stefanVanadium/mp3-player/mp3_player.tex

\documentclass[11pt,a4paper]{article}
\usepackage[utf8]{inputenc}
\usepackage[T1]{fontenc}
\usepackage[english]{babel}
\usepackage[margin=2.5cm]{geometry}
\usepackage{graphicx}
\usepackage{hyperref}

\title{MP3 Player}
\author{Stefan Jipa}
\date{\today}

\begin{document}
\maketitle
\tableofcontents
\newpage

\section{Goal}

\section{Requirements}

\section{Components}

\section{Schematic}

\section{Software}

\section{Tests}

\section{Resources}

\end{document}
