stefanVanadium/mp3-player/enclosure/out/compare.png

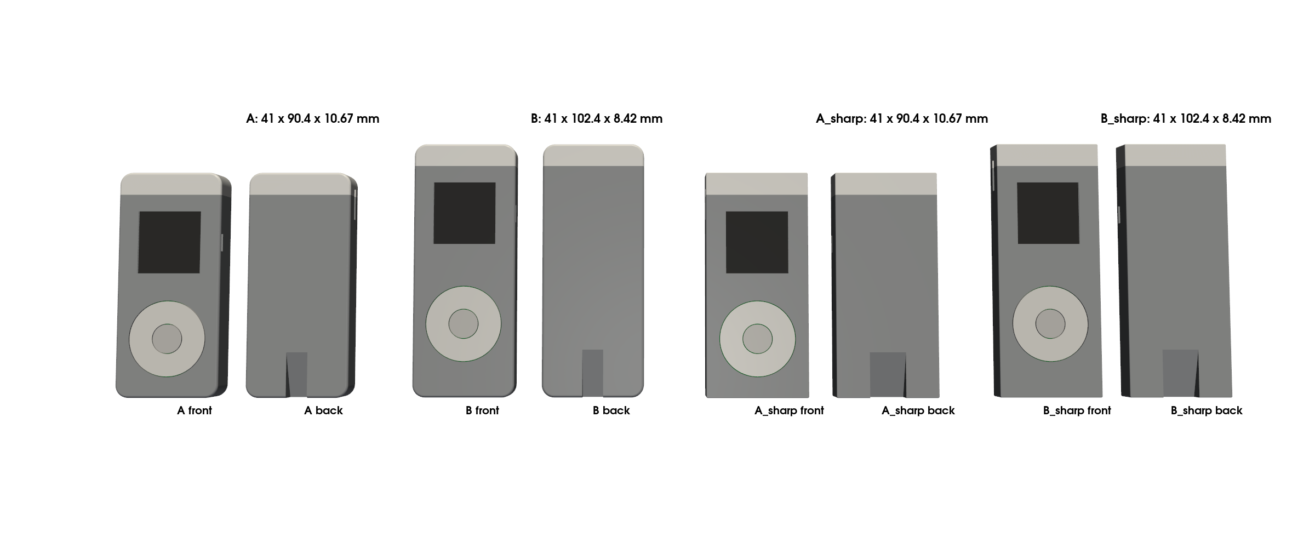
enclosure/out/compare.png
