stefanVanadium/mp3-player/enclosure/out/ends_ortho.png

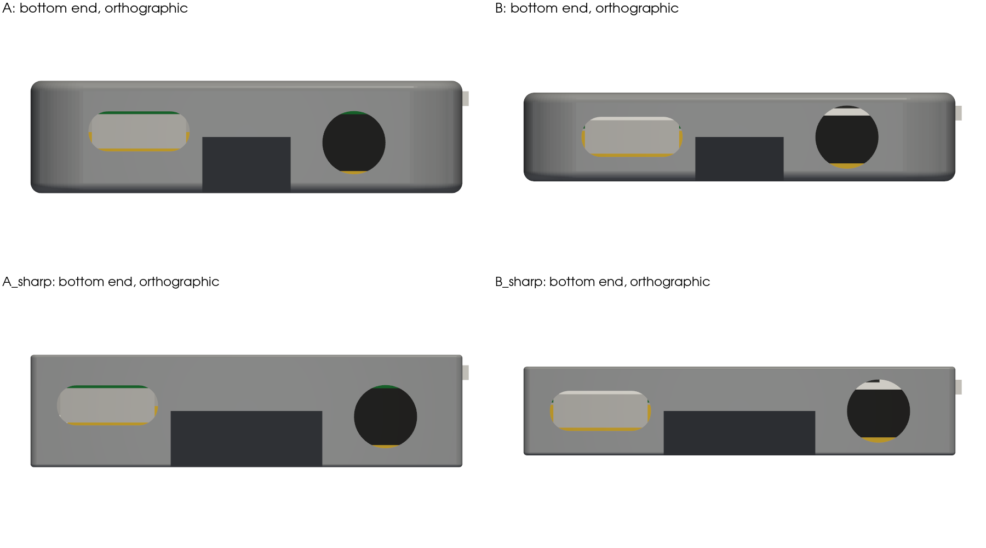
enclosure/out/ends_ortho.png
