stefanVanadium/mp3-player/enclosure/out/render_A.png

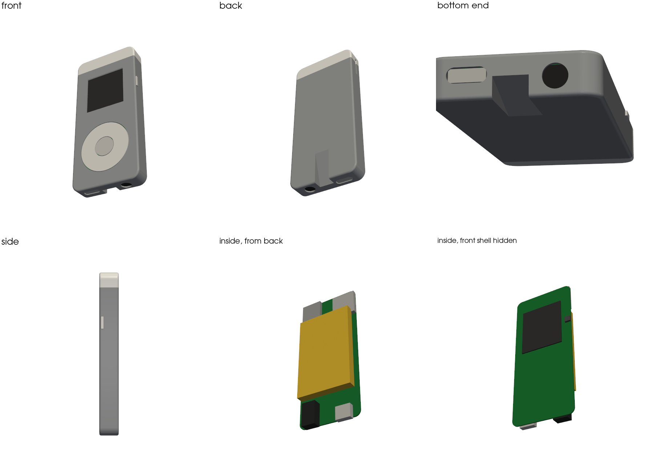
enclosure/out/render_A.png
