stefanVanadium/mp3-player/enclosure/out/render_B_sharp.png

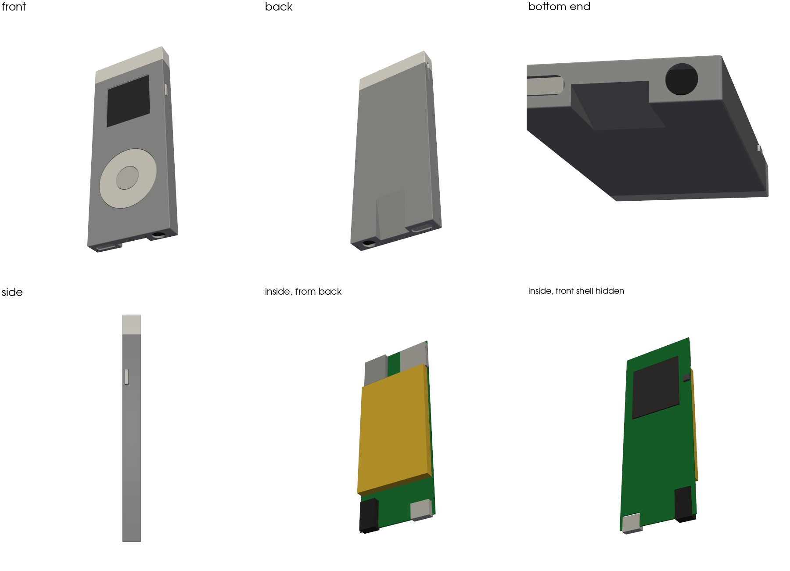
enclosure/out/render_B_sharp.png
