stefanVanadium/mp3-player/enclosure/out/concept_B_body.stl

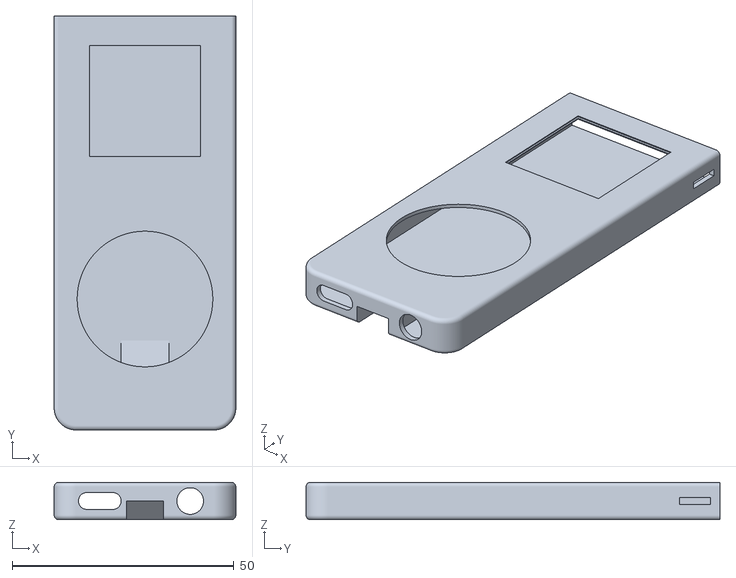
[picture p6: CAD file, 2026-10-23]
enclosure/out/concept_B_body.stl
41.0 x 93.4 x 8.42
