stefanVanadium/mp3-player/examplev1.dxf

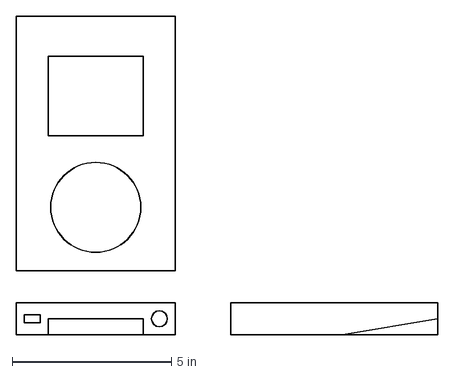
[picture p7: CAD file, 2026-10-22]
examplev1.dxf
13.2 x 10.0 in
