stefanVanadium/mp3-player/enclosure/out/concept_A_body.stl

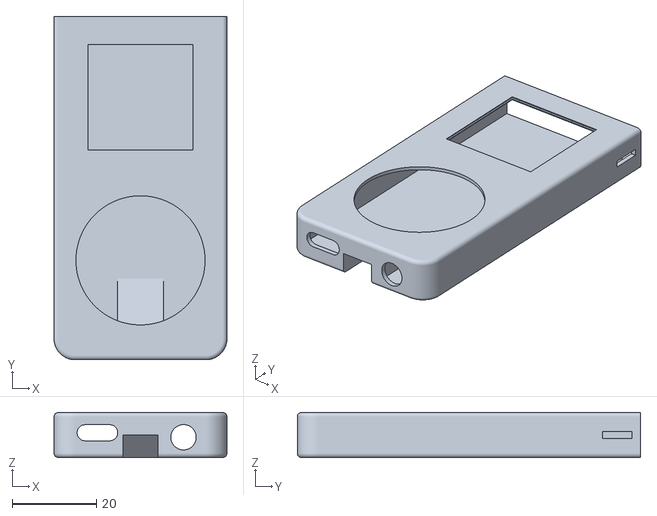
[picture p8: CAD file, 2026-10-23]
enclosure/out/concept_A_body.stl
41.0 x 81.4 x 10.7
