stefanVanadium/mp3-player/enclosure/out/concept_A_sharp.step

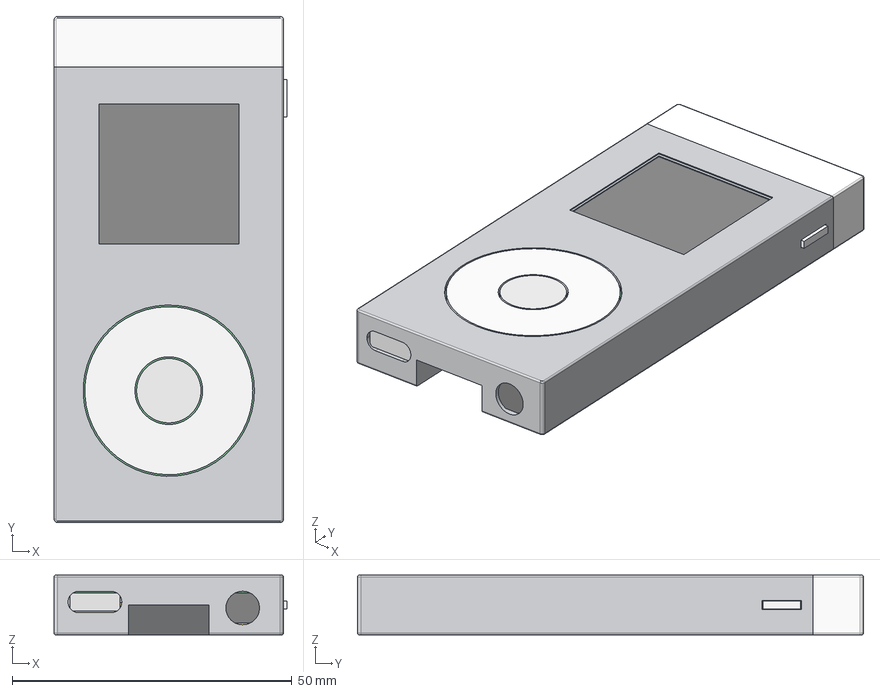
[picture p9: CAD file, 2026-10-23]
enclosure/out/concept_A_sharp.step
41.6 x 90.4 x 10.7 mm
body (anodized aluminium)
cap (3D printed)
click wheel (3D printed)
play button (3D printed)
PCB
LS013B7DH03
LiPo 34x54x5
ESP32-PICO-MINI-02
TF-01A
EVQP7J01P
power key (3D printed)
PJ-342 (C668606)
TYPE-C-31-M-12 (C165948)
