stefanVanadium/mp3-player/enclosure/out/concept_B_sharp.step

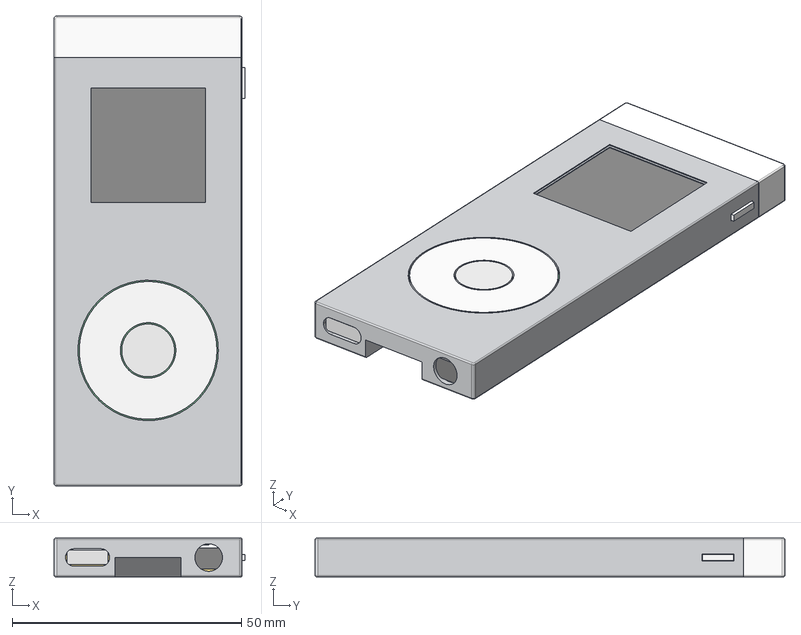
[picture p11: CAD file, 2026-10-23]
enclosure/out/concept_B_sharp.step
41.6 x 102.4 x 8.42 mm
body (anodized aluminium)
cap (3D printed)
click wheel (3D printed)
play button (3D printed)
PCB
LS013B7DH03
LiPo 37x63x4
ESP32-PICO-MINI-02
TF-01A
EVQP7J01P
power key (3D printed)
PJ-342C CB (C49287245)
TYPE-C 16P CB0.8 073 (C2906289)
