stefanVanadium/mp3-player/enclosure/out/pcb_outline_A.dxf

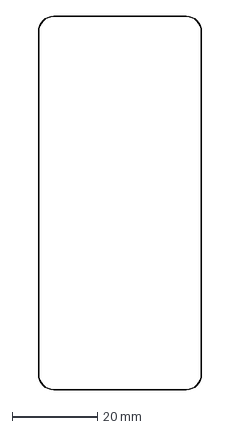
[picture p12: CAD file, 2026-10-22]
enclosure/out/pcb_outline_A.dxf
38.2 x 87.6 mm
