stefanVanadium/mp3-player/enclosure/out/pcb_outline_A_sharp.dxf

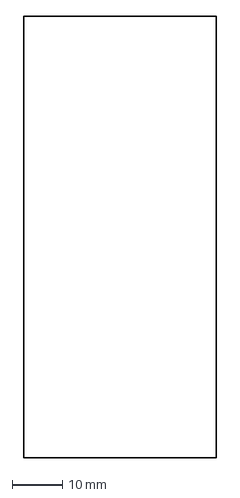
[picture p13: CAD file, 2026-10-22]
enclosure/out/pcb_outline_A_sharp.dxf
38.2 x 87.6 mm
