stefanVanadium/mp3-player/enclosure/out/pcb_outline_B.dxf

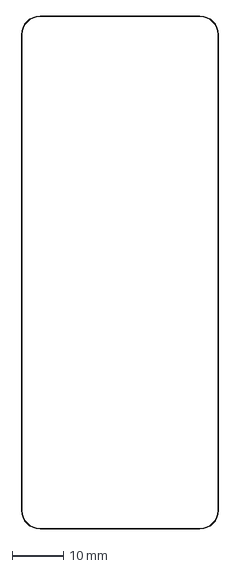
[picture p14: CAD file, 2026-10-22]
enclosure/out/pcb_outline_B.dxf
38.2 x 99.6 mm
