stefanVanadium/mp3-player/enclosure/out/pcb_outline_B_sharp.dxf

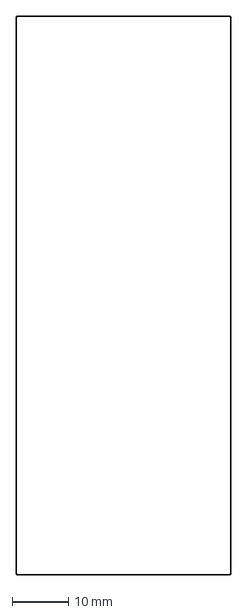
[picture p15: CAD file, 2026-10-22]
enclosure/out/pcb_outline_B_sharp.dxf
38.2 x 99.6 mm
