stefanVanadium/mp3-player/(list of files, cad)

Other CAD files:
enclosure/out/concept_B_sharp_body.stl
enclosure/out/concept_A.step
enclosure/out/concept_A_sharp_body.stl
