stefanVanadium/mp3-player/mp3_player.kicad_pcb

## KiCad design mp3_player.kicad_pcb (2026-10-24)

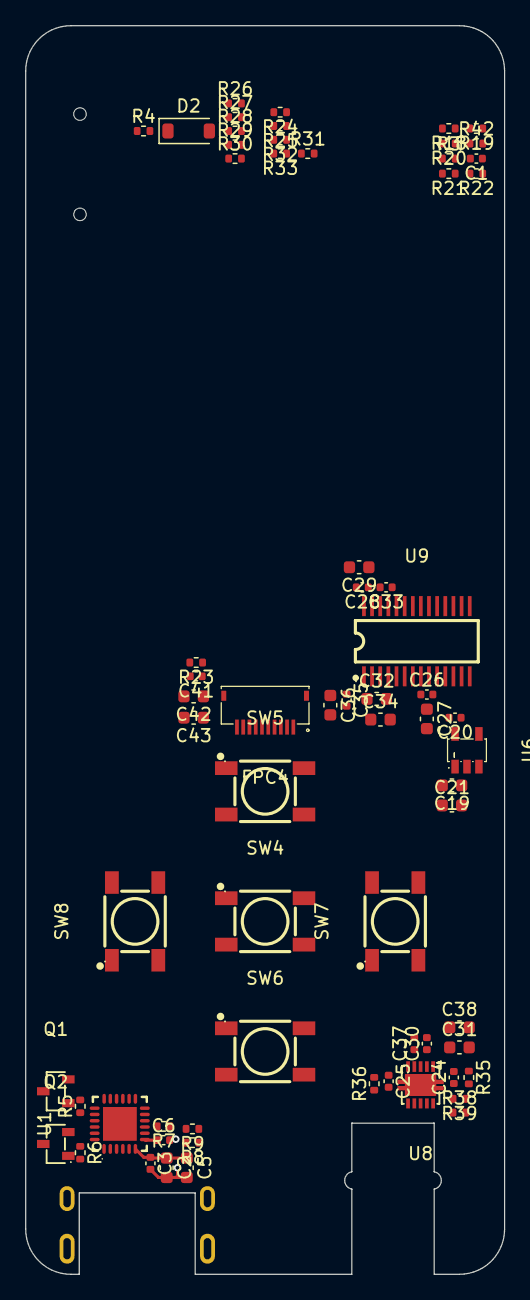
[picture p16: board mp3_player.kicad_pcb from above]

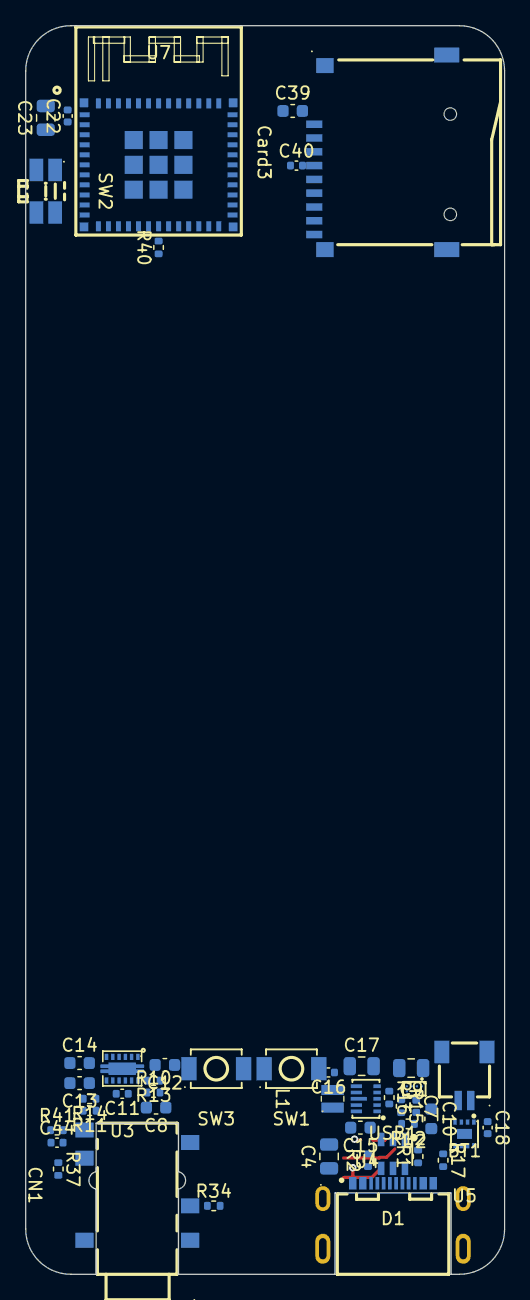
[picture p17: board mp3_player.kicad_pcb from below]

Board: 4 copper layers, 38.2 x 99.6 mm, 113 parts (46 on the bottom side), 69 nets.

Parts:
BT1: Battery_Cell; CONN-SMD_2P-P1.00_SM02B-SRSS-TB-LF-SN
C1, C3, C6, C7, C11, C16, C18, C20, C22, C24, C25, C26, C28, C30, C33, C35, C37, C40, C41: C; C_0402_1005Metric
C2, C5, C8, C10, C12, C13, C14, C15, C19, C21, C27, C29, C31, C32, C34, C36, C38, C39, C42, C43: C; C_0603_1608Metric
C4, C9, C17, C23: C; C_0805_2012Metric
C44: 100nF; C_0402_1005Metric
CN1: PJ-342C CB; AUDIO-SMD_HX-PJ-342C
Card3: TF-01A; TF-SMD_TF-01A
D1: USBLC6-2SC6; SOT-23-6_L2.9-W1.6-P0.95-LS2.8-BL
D2: D_Schottky; D_SOD-123
FPC4: FH19C-10S-0.5SH(10); FPC-SMD_10P-P0.50_FH19C-10S-0.5SH-10
L1: WPN201610HR47MT; IND-SMD_L2.0-W1.6_WPN2016X
Q1, Q2: MMBT3904-C20526; SOT-23-3_L2.9-W1.3-P1.90-LS2.4-BR
R1, R2, R3, R4, R5, R6, R7, R8, R9, R10, R11, R12, R13, R14, R15, R16, R17, R18, R19, R20, R21, R22, R23, R24, R25, R26, R27, R28, R29, R30, R31, R32, R33, R34, R35, R36, R37, R38, R39, R40, R41, R42: R; R_0402_1005Metric
SW1, SW3: TS-1088-AR02016; SW-SMD_L3.9-W3.0-P4.45
SW2: EVQP7J01P; SW-SMD_EVQP7J01P
SW4, SW5, SW6, SW7, SW8: TS-1187B-B; KEY-SMD_4P-L4.8-W4.8-P3.70-LS6.4-TL
U1: CP2102N-A02-GQFN24R; QFN-24_L4.0-W4.0-P0.50-TL-EP2.6
U2: BQ25180YBGR; DSBGA-8_L1.6-W0.9-R2-C4-P0.40-BL
U3: LM27762DSSR; WSON-12_L3.0-W2.0-P0.50-BL-EP
U4: TPS63802DLAR; VSON-10_L3.0-W2.0-P0.50-TL
U5: MAX17048G+T10; TDFN-8_L2.0-W2.0-P0.50-BL-EP1.2
U6: LP5907MFX-3.3/NOPB; SOT-23-5_L3.0-W1.7-P0.95-LS2.8-BR
U7: ESP32-PICO-MINI-02-N8R2; BULETM-SMD_ESP32-PICO-MINI-02-N8R2
U8: OPA1622IDRCR; VSON-10_L3.0-W3.0-P0.50-BL-EP1.65
U9: PCM5122PW; TSSOP-28_L9.8-W6.6-P0.65-BL
USB1: TYPE-C 16P CB0.8 073; USB-C-SMD_TYPE-C-16P-CB0.8-073

Connections:
+3V0_AMP: C8.2, C30.1, C31.1, R13.1, R39.1, U3.11 (OUT+), U8.2 (V+)
+3V3: C2.1, C3.1, C5.1, C6.1, C16.1, C17.1, C22.1, C23.1, C28.1, C29.1, C39.2, C40.2, C42.1, C43.1, Card3.4 (VDD), FPC4.6, FPC4.7, R3.1, R4.1, R7.1, R15.2, R17.2, R18.2, R19.2, R20.2, R21.2, R22.2, R24.2, R25.2, R26.2, R27.2, R28.2, R29.2, R30.2, R31.2, R32.2, R42.1, U1.5 (VIO), U1.6 (VDD), U1.7 (VREGIN), U4.6 (VOUT), U7.3 (3V3), U9.18 (MODE2), U9.28 (DVDD)
+3V3_A: C20.2, C26.1, C27.1, C35.1, C36.1, U6.5 (OUT), U9.1 (CPVDD), U9.8 (AVDD)
-3V0_AMP: C14.2, C37.1, C38.1, R14.2, U3.6 (OUT–), U8.4 (V-), U8.11 (V-(EP))
AMP_INL: C24.2, R35.1, U8.1 (+INA)
AMP_INR: C25.1, R36.2, U8.5 (+INB)
AUDIO_EN: R33.1, U3.8 (EN–), U3.12 (EN+), U7.27 (IO7), U9.25 (XSMT)
BTN_NEXT: R19.1, SW7.1, U7.5 (I37)
BTN_PLAY: R31.1, SW4.1, U7.26 (IO20)
BTN_PREV: R20.1, SW8.1, U7.6 (I38)
BTN_VOLDN: R22.1, SW6.1, U7.10 (I35)
BTN_VOLUP: R21.1, SW5.1, U7.9 (I34)
DAC_L: R35.2, U9.6 (OUTL)
DAC_R: R36.1, U9.7 (OUTR)
DTR: Q2.2 (E), R5.1, U1.23 (DTR)
ESP_BOOT: D2.1 (K), Q2.3 (C), R4.2, SW3.1, U7.23 (IO0)
ESP_EN: C1.2, Q1.3 (C), R3.2, SW1.2, U7.8 (EN)
ESP_RX: U1.21 (TXD), U7.30 (RXD0)
ESP_TX: U1.20 (RXD), U7.31 (TXD0)
GND: BT1.2 (-), C1.1, C2.2, C3.2, C4.2, C5.2, C6.2, C7.2, C8.1, C9.2, C10.2, C12.1, C13.2, C14.1, C15.1, C16.2, C17.2, C18.2, C19.2, C20.1, C21.1, C22.2, C23.2, C24.1, C25.2, C26.2, C27.2, C28.2, C29.2, C30.2, C31.2, C33.1, C34.1, C35.2, C36.2, C37.2, C38.2, C39.1, C40.1, C41.2, C42.2, C43.2, C44.1, CN1.1 (MIC), CN1.2 (GND), Card3.6 (VSS), Card3.10 (GND), Card3.11 (GND), Card3.12 (GND), Card3.13 (GND), D1.2, FPC4.4, FPC4.8, FPC4.9, FPC4.10, FPC4.11, FPC4.12, R1.2, R2.2, R9.1, R10.2, R11.2, R12.1, R16.2, R23.2, R33.2, R34.2, R37.2, R38.2, SW1.1, SW2.2, SW3.2, SW4.2, SW5.2, SW6.2, SW7.2, SW8.2, U1.2 (GND), U1.25 (GND), U2.D2 (GND), U3.1 (PGOOD), U3.4 (GND), U3.13 (EP), U4.2 (MODE), U4.3 (AGND), U4.8 (GND), U5.1 (CTG), U5.4 (GND), U5.6 (QSTRT), U5.9 (EP), U6.2 (GND), U7.1 (GND), U7.2 (GND), U7.11 (GND), U7.14 (GND), U7.36 (GND), U7.37 (GND), U7.38 (GND), U7.39 (GND), U7.40 (GND), U7.41 (GND), U7.42 (GND), U7.43 (GND), U7.44 (GND), U7.45 (GND), U7.46 (GND), U7.47 (GND), U7.48 (GND), U7.49 (GND), U7.50 (GND), U7.51 (GND), U7.52 (GND), U7.53 (GND), U8.3 (GND), U9.3 (CPGND), U9.9 (AGND), U9.10 (VCOM), U9.16 (ADR2), U9.17 (MODE1), U9.20 (SCK), U9.24 (ADR1), U9.27 (DGND), USB1.0, USB1.A1B12 (GND), USB1.B1A12 (GND)
HP_L: CN1.4 (AU-L), R37.1, U8.9 (OUTA), U8.10 (-INA)
HP_R: CN1.3 (AU-R), R34.1, U8.6 (-INB), U8.7 (OUTB)
I2C_SCL: R25.1, U2.B1 (SCL), U5.7 (SCL), U7.34 (IO22), U9.12 (SCL)
I2C_SDA: R24.1, U2.C1 (SDA), U5.8 (SDA), U7.35 (IO21), U9.11 (SDA)
I2S_BCK: U7.16 (IO26), U9.21 (BCK)
I2S_DOUT: U7.17 (IO27), U9.22 (DIN)
I2S_LRCK: U7.15 (IO25), U9.23 (LRCK)
JACK_DET: C44.2, R41.1, R42.2, U7.7 (I39)
JACK_SW: CN1.6 (HP-DET), R41.2
LCD_CS: FPC4.3, U7.12 (IO32)
LCD_DISP: C41.1, FPC4.5, R23.1, U7.13 (IO33)
LCD_MOSI: FPC4.2, U7.33 (IO19)
LCD_SCK: FPC4.1, U7.29 (IO5)
unnamed: Card3.5 (CLK(SCLK)), R40.1
unnamed: Q1.1 (B), R5.2
unnamed: Q2.1 (B), R6.2
unnamed: R7.2, U1.9 (RSTb)
unnamed: R8.2, R9.2, U1.8 (VBUS)
unnamed: R12.2, SW2.1, U2.D1 (TS/MR)
unnamed: C11.1, U3.10 (C1+)
unnamed: C11.2, U3.9 (C1–)
unnamed: C13.1, U3.5 (CP)
unnamed: R10.1, R13.2, U3.2 (FB+)
unnamed: R11.1, R14.1, U3.7 (FB–)
unnamed: R15.1, R16.1, U4.4 (FB)
unnamed: L1.1, U4.9 (L1)
unnamed: L1.2, U4.7 (L2)
unnamed: R17.1, U4.5 (PG)
unnamed: R38.1, R39.2, U8.8 (EN)
unnamed: C32.2, U9.4 (CAPM)
unnamed: C32.1, U9.2 (CAPP)
unnamed: C33.2, U9.26 (LDOO)
unnamed: C34.2, U9.5 (VNEG)
unnamed: R2.1, USB1.A5 (CC1)
unnamed: R1.1, USB1.B5 (CC2)
PWR_INT: R32.1, U2.A1 (/INT), U5.5 (~ALRT), U7.28 (IO8)
RTS: Q1.2 (E), R6.1, U1.19 (RTS)
SD_CLK: R40.2, U7.18 (IO14)
SD_CMD: Card3.3 (CMD(DI)), R28.1, U7.21 (IO15)
SD_D0: Card3.7 (DAT0(D0)), D2.2 (A), R29.1, U7.22 (IO2)
SD_D1: Card3.8 (DAT1(RSV)), R30.1, U7.24 (IO4)
SD_D2: Card3.1 (DAT2(RSV)), R26.1, U7.19 (IO12)
SD_D3: Card3.2 (CDDAT3(CS)), R27.1, U7.20 (IO13)
SD_DET: Card3.9 (CD), R18.1, U7.4 (I36)
USB_DN: D1.3, D1.4, U1.4 (D-), USB1.A7 (DN1), USB1.B7 (DN2)
USB_DP: D1.1, D1.6, U1.3 (D+), USB1.A6 (DP1), USB1.B6 (DP2)
VBAT: BT1.1 (+), C7.1, C18.1, U2.C2 (BAT), U5.2 (CELL), U5.3 (VDD)
VBUS: C4.1, C10.1, D1.5, R8.1, U2.A2 (IN), USB1.A4B9 (VBUS), USB1.B4A9 (VBUS)
VSYS: C9.1, C12.2, C15.2, C19.1, C21.2, U2.B2 (SYS), U3.3 (VIN), U4.1 (EN), U4.10 (VIN), U6.1 (IN), U6.3 (EN)
