stefanVanadium/mp3-player/(commit log)

2026-10-20 Initial project: architecture, BOM, KiCad libraries, datasheets
2026-10-21 Verify pins, add connection list, fix design issues
    - conexiuni.md: pin-by-pin connections for every block, ESP32 GPIO map
    - swap CP2102N QFN20 -> QFN24 (C969151): QFN20 has no DTR for auto-reset
    - OPA1622 pin 11 renamed V-(EP): thermal pad goes to V-, not GND
    - B5819W diode GPIO2->GPIO0 so download mode works with SD D0 pull-up
    - code.md: eFuse step for GPIO12, firmware limits, MAX17048 EnSleep
    - single ground plane note, MAX17048 datasheet added
2026-10-21 Schematic: USB-C, ESD, CP2102N and auto-reset sheet
    USB-C with CC pull-downs, USBLC6 on D+/D-, CP2102N QFN24 on +3V3 with
    VBUS sense divider, DTR/RTS auto-reset (2x MMBT3904), B5819W boot diode.
    Global labels ESP_EN/ESP_BOOT/ESP_TX/ESP_RX/SD_D0 for the ESP32 sheet.
    Ignore KiCad .history/.
2026-10-21 Schematic: power sheet
    BQ25180 charger with power button on TS/MR, TPS63802 3.3V buck-boost
    (511k/91k feedback), LP5907 3.3V analog LDO, LM27762 +/-3V amp rails
    (150k/100k, 147k/100k), MAX17048 fuel gauge on the battery.
2026-10-21 Schematic: ESP32 sheet
    ESP32-PICO-MINI-02 with global labels for every used pin, 22uF + 0.1uF
    on 3V3, SDMMC pull-ups, I2C 4.7k pull-ups, PWR_INT and button pull-ups,
    AUDIO_EN 100k pull-down, BOOT and PLAY buttons.
2026-10-21 Schematic: audio sheet
    PCM5122 in I2C mode (addr 0x4C, BCK PLL, XSMT on AUDIO_EN), AVDD/CPVDD
    on the clean +3V3_A rail and DVDD on +3V3. 470R/2.2nF output filters,
    OPA1622 unity-gain buffer on +/-3V with EP on V- and EN divider from V+,
    PJ-342 jack with 10k bleeders and JACK_SW detect contact.
2026-10-21 Schematic: microSD, display and buttons sheet; drop ST7567
    - microSD (TF-01A) with 33R on CLK and decoupling
    - Sharp LS013B7DH03 on FH12-10S, DISP on IO33 (LCD_DISP, 100k pull-down,
    0.1uF per Sharp), EXTMODE/EXTCOMIN to GND
    - VOL+/VOL-/NEXT/PREV buttons, jack detect (100k series + 1M pull-up)
    - ST7567 removed: Sharp is the only display (same display across projects)
2026-10-21 Schematic done
    - sheet files renamed to English (usb, power, esp32, audio, io)
    - final layout, annotation R1-R42 / C1-C43 / U1-U9 / J1-J4 / SW1-SW8
    - all buttons are TS-1088, project R/C symbols, PWR_FLAGs
    - connections.md replaces conexiuni.md (English, final references)
    - final check on the KiCad netlist: 278/278 checks against connections.md
    - status updated; firmware note: BQ25180 charge current defaults to ~10 mA
2026-10-21 Assign footprints and LCSC parts to passives, D2 and BT1
    Thin-film 0.1% resistors in the audio path and rail dividers, C0G caps
    in the DAC output filter, Samsung/Murata MLCCs with 0603/0805 cases for
    bulk caps. Passive choices documented in mp3_player.md.
2026-10-21 BT1: JST PH footprint with 3D model from LCSC
    KiCad's stock S2B-PH-SM4-TB footprint has no 3D model, so use the
    EasyEDA one (C295747) like the other custom parts.
2026-10-21 Choose 1000 mAh LiPo battery
2026-10-22 Fix ERC and document enclosure concept
    - ERC clean: power flags moved onto real nets, USBLC6 pin types,
    Unspecified pins allowed in the pin conflict map, off-grid wires aligned
    - mp3_player.md: enclosure section (anodized aluminium v1, titanium v2,
    printed click wheel and antenna cap, build123d workflow)
    - ignore the build123d venv
2026-10-22 Enclosure concept: iPod-style shell in build123d, two variants
    - enclosure/concept.py: parametric shell with display window, click wheel,
    printed antenna cap, back ramp, side microSD slot and centred bottom ports
    - variant A (503450 stacked, 41x90.4x10.7) and B (LP403759 beside the
    parts, sinking USB-C C2906289 + PJ-342C CB, 41x102.4x8.4), each rounded
    and sharp; B rounded chosen
    - STEP, STL and renders in enclosure/out, render scripts in enclosure/render
    - examplev1.dxf: first design sketch
    - mp3_player.md: final variants, trade-offs and follow-up changes
2026-10-22 Schematic and parts for enclosure B
    - jack PJ-342C CB (TRRS, sinking) as CN1, HP-DET on JACK_SW, MIC to GND,
    100nF on JACK_DET (detect is now active low)
    - USB-C TYPE-C 16P CB0.8 073 (sinking, 0.8 mm board) as USB1
    - BT1 on JST SH SM02B-SRSS-TB, click wheel on TS-1187B-B (0.75 mm),
    power on EVQP7J01P side switch
    - new footprints/3D models in lib; switch and JST SH footprints renumbered
    so the existing 2-pin symbols fit
    - enclosure: power key on the right side, level with the display
    - docs: connections.md, code.md and BOM updated
    ERC: 0 errors, 0 warnings.
2026-10-22 README: concept render of the enclosure
    - enclosure/render/hero.py: front + back 3/4 view of variant B, cropped,
    transparent background (out/hero_B.png)
    - README: render at the top, case and battery in the spec table,
    enclosure folder and status
2026-10-22 Board setup and PCB outline for enclosure B
    - 4-layer 0.8 mm ENIG stackup (In1/In2 ground planes), JLC-safe design
    rules, Power net class (0.4 mm) for the supply rails
    - concept.py exports the board outline as DXF (pcb_outline_B.dxf,
    38.2 x 99.6 mm, R3.6)
2026-10-23 PCB: outline, port cutouts, ESP32 placement
    - board outline from pcb_outline_B.dxf, centred on the page, drill/place
    and grid origin at the bottom-left corner (130, 155)
    - USB-C and jack cutouts drawn on the board outline instead of the
    footprints; jack pads trimmed for 0.2 mm to the slot, custom DRC rule
    allows 0.2 mm edge clearance for those pads only
    - ESP32 on the centre line with the antenna at the top edge, antenna
    keepout on all copper layers
    - microSD peg holes made non-plated
2026-10-23 PCB: tall parts on the back, top strip layout, centred power key
    - USB-C, jack, ESP32, microSD and power switch on the back of the board,
    as the enclosure B model assumes (front stack is only 1.6 mm)
    - top strip: microSD left (stays inside, no shell slot), ESP32 right with
    the antenna at the top edge, power switch at the right edge
    - power switch hangs under the PCB, so its actuator lands 0.1 mm from
    mid-thickness; the side opening is now centred on the shell
    - antenna keepout narrowed to the antenna side of the top strip
    - concept.py follows the new positions; the ESP32 no longer hits the cap
    and the SD socket no longer hits the battery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
2026-10-23 PCB: place the remaining chips and the buttons
    - power corner on the back, bottom-left between the battery end and
    USB-C: battery connector, BQ25180, MAX17048, USBLC6, TPS63802 + L1
    - CP2102N with the auto-reset transistors on the front, bottom-left
    - PCM5122 + LP5907 in the middle band, ~40 mm from the inductor;
    OPA1622 at the jack on the front, LM27762 behind it on the back
    - click wheel switches on the ring, EN/BOOT on the back under the ramp
    - space under the display kept free for a low-profile FPC connector
    (FH12 is too tall for either side)
2026-10-23 Display connector: FH19C-10S, placed under the display
    - FH12 (2.0 mm) fits neither side of the board; FH19C-10S-0.5SH(10)
    (C598004) is 0.9 mm tall, bottom contact, same 10 pins
    - footprint and 3D model from LCSC added to the project library;
    schematic fields (value, footprint, datasheet, LCSC) updated
    - FPC4 on the front at (149.1, 110.1), opening toward the display: the
    LCD tail lies flat into it, flex pin 1 and connector pin 1 both on
    the right
    - docs: BOM, placement checklist and connections.md follow the swap
2026-10-24 PCB: place all resistors and capacitors
    - every passive sits next to the pin it serves, rotated so its non-GND
    pad faces that pin; decoupling caps hug their supply pins
    - back: power corner (BQ25180, TPS63802, MAX17048, USB-C CC/VBUS),
    LM27762 pump, feedback and output caps, jack detect and bleeders,
    ESP32 3V3 and microSD decoupling, SD_CLK series resistor at the source
    - front: CP2102N, PCM5122, LP5907, OPA1622 (supply caps, RC input
    filter, EN divider), display caps, pull-ups grouped by ESP32 pin side
    - U6 LP5907 moved to (165.2, 113.2) to free the DAC charge-pump pins;
    U8 OPA1622 moved up 0.6 mm so its EN trace clears the jack cutout
    - all parts checked against the enclosure: no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
2026-10-24 PCB: GND plane on In1, first routing (CP2102N decoupling)
    - GND zone on the inner GND layer, whole board
    - C2, C3, C5, C6 routed to U1 pins 6/7 with 0.25 mm tracks
    - C2/C3/C5 share one GND via (kept off the USB-C GND pad on the back),
    C6 has its own GND via
